jyothikiran25/air-mouse-pcb/docs/board-top.png

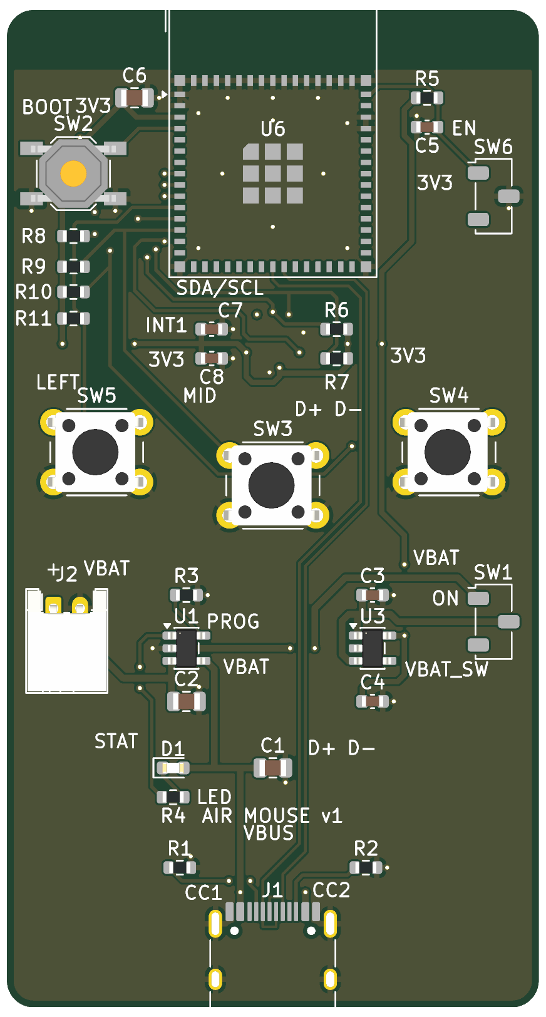
docs/board-top.png
