jyothikiran25/air-mouse-pcb/docs/route-map.png

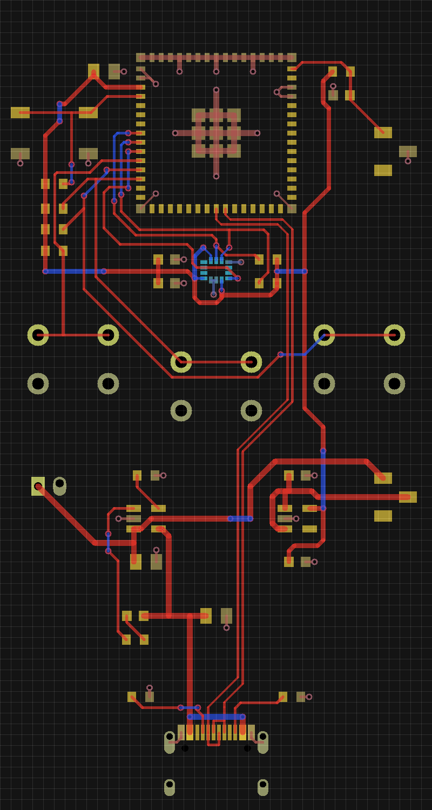
docs/route-map.png
