jyothikiran25/air-mouse-pcb/AIR_MOUSE.kicad_pcb

## KiCad design AIR_MOUSE.kicad_pcb (2026-11-07)

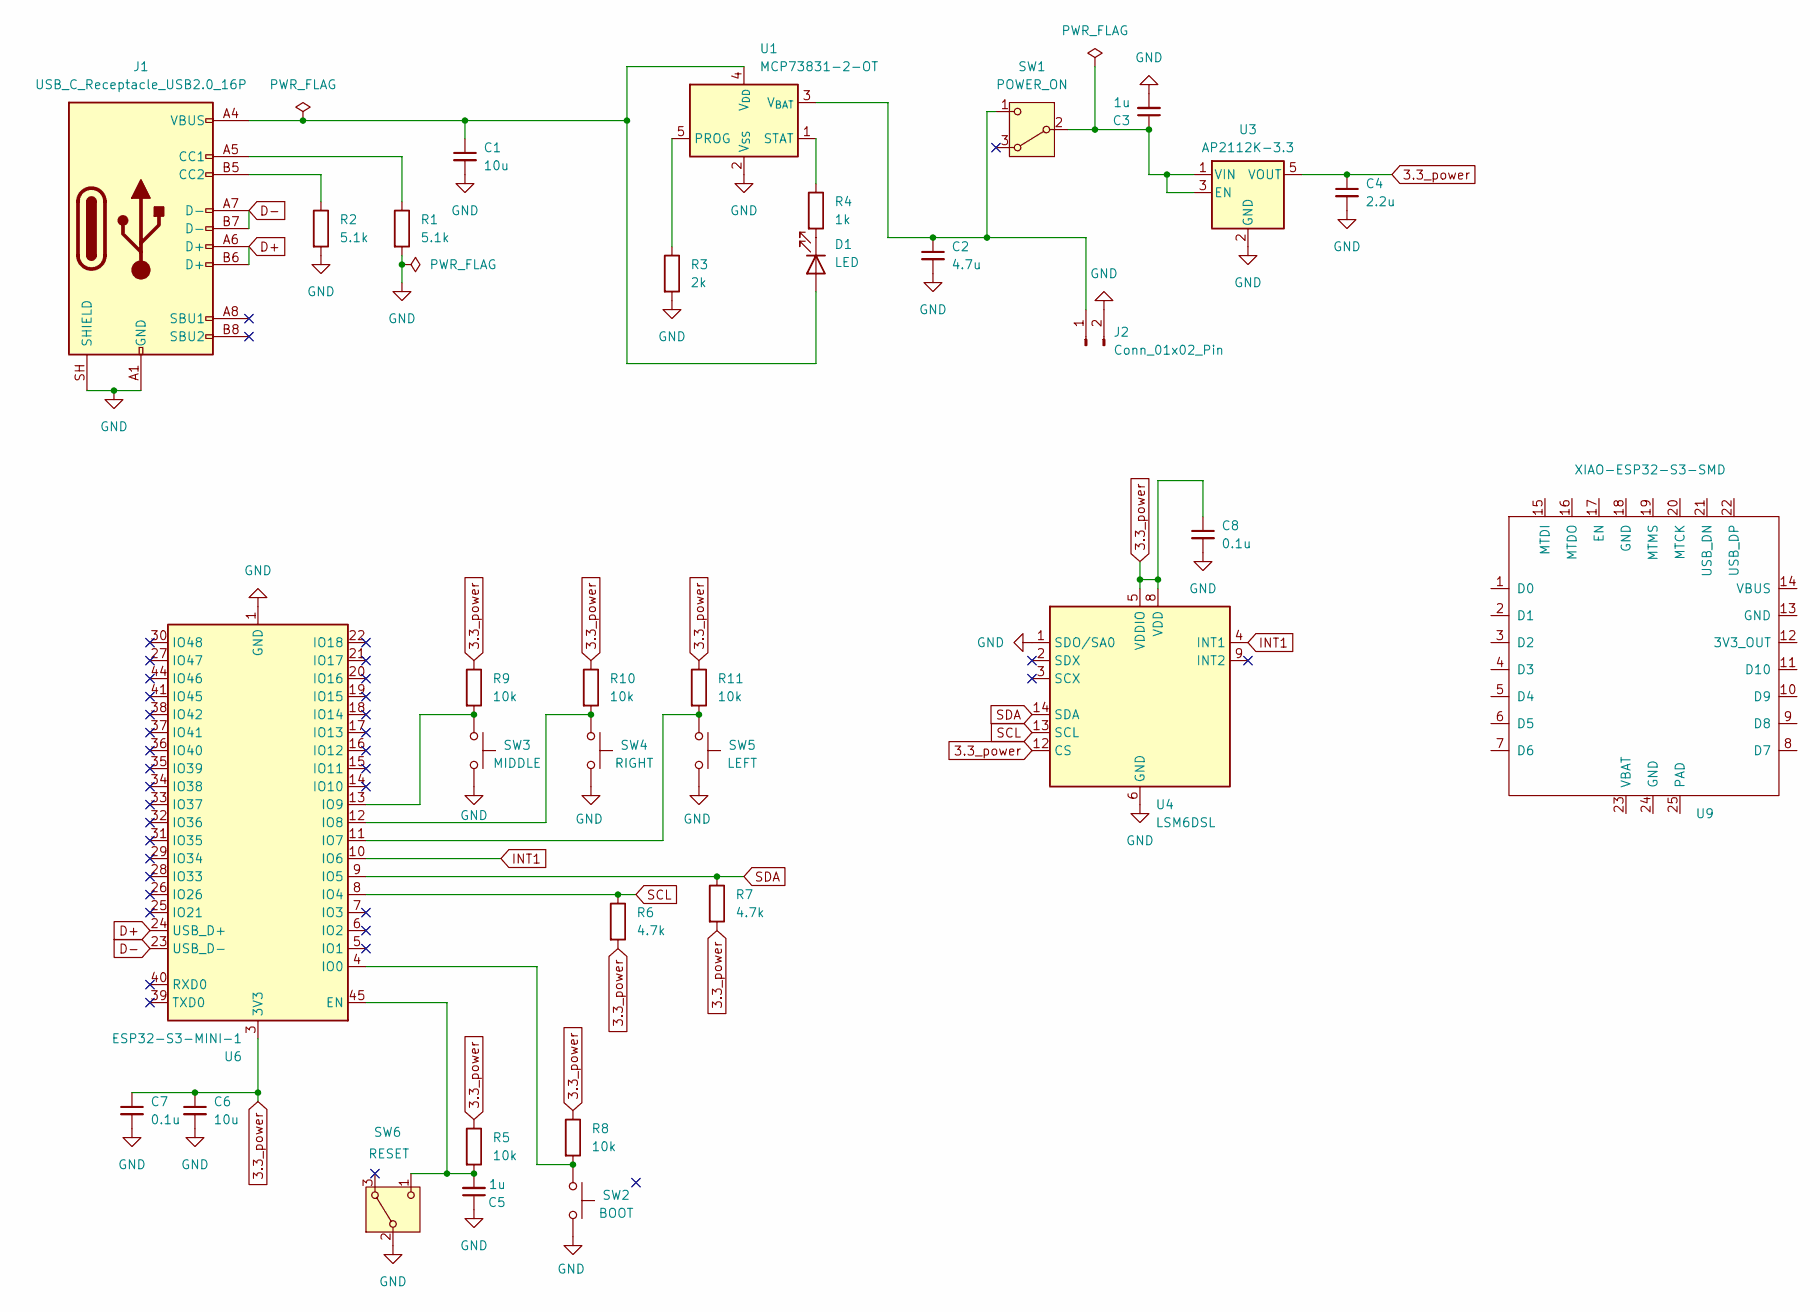
[picture p3: schematic AIR_MOUSE.kicad_sch]

Parts:
C1, C6: 10u; C_0805_2012Metric
C2: 4.7u; C_0805_2012Metric
C3, C5: 1u; C_0603_1608Metric
C4: 2.2u; C_0603_1608Metric
C7, C8: 0.1u; C_0603_1608Metric
D1: LED; LED_0603_1608Metric
J1: USB_C_Receptacle_USB2.0_16P; USB_C_Receptacle_HRO_TYPE-C-31-M-12
J2: Conn_01x02_Pin; JST_PH_S2B-PH-K_1x02_P2.00mm_Horizontal
R1, R2: 5.1k; R_0603_1608Metric
R3: 2k; R_0603_1608Metric
R4: 1k; R_0603_1608Metric
R5, R8, R9, R10, R11: 10k; R_0603_1608Metric
R6, R7: 4.7k; R_0603_1608Metric
SW1: POWER_ON; Nidec_Copal_CAS-120A
SW2: BOOT; SW_SPST_TL3342
SW3: MIDDLE; SW_PUSH_6mm_H5mm
SW4: RIGHT; SW_PUSH_6mm_H5mm
SW5: LEFT; SW_PUSH_6mm_H5mm
SW6: RESET; Nidec_Copal_CAS-120A
U1: MCP73831-2-OT; SOT-23-5
U3: AP2112K-3.3; SOT-23-5
U4: LSM6DSL; LGA-14_3x2.5mm_P0.5mm_LayoutBorder3x4y
U6: ESP32-S3-MINI-1; ESP32-S2-MINI-1
U9: XIAO-ESP32-S3-SMD

Connections:
3.3_power: C4.1, C6.1, C7.1, C8.1, R5.1, R6.2, R7.2, R8.1, R9.1, R10.1, R11.1, U3.5 (VOUT), U4.5 (VDDIO), U4.8 (VDD), U4.12 (CS), U6.3 (3V3)
D+: J1.A6 (D+), J1.B6 (D+), U6.24 (USB_D+)
D-: J1.A7 (D-), J1.B7 (D-), U6.23 (USB_D-)
GND: C1.2, C2.2, C3.2, C4.2, C5.1, C6.2, C7.2, C8.2, J1.A1 (GND), J1.A12 (GND), J1.B1 (GND), J1.B12 (GND), J1.SH (SHIELD), J2.2, R1.2, R2.2, R3.2, SW2.2, SW3.2, SW4.2, SW5.2, SW6.2 (B), U1.2 (V_{SS}), U3.2 (GND), U4.1 (SDO/SA0), U4.6 (GND), U4.7 (GND), U6.1 (GND), U6.2 (GND), U6.42 (GND), U6.43 (GND), U6.46 (GND), U6.47 (GND), U6.48 (GND), U6.49 (GND), U6.50 (GND), U6.51 (GND), U6.52 (GND), U6.53 (GND), U6.54 (GND), U6.55 (GND), U6.56 (GND), U6.57 (GND), U6.58 (GND), U6.59 (GND), U6.60 (GND), U6.61 (GND), U6.62 (GND), U6.63 (GND), U6.64 (GND), U6.65 (GND)
INT1: U4.4 (INT1), U6.10 (IO6)
unnamed: C1.1, D1.2 (A), J1.A4 (VBUS), J1.A9 (VBUS), J1.B4 (VBUS), J1.B9 (VBUS), U1.4 (V_{DD})
unnamed: D1.1 (K), R4.2
unnamed: J1.A5 (CC1), R1.1
unnamed: J1.B5 (CC2), R2.1
unnamed: C2.1, J2.1, SW1.1 (C), U1.3 (V_{BAT})
unnamed: C3.1, SW1.2 (B), U3.1 (VIN), U3.3 (EN)
unnamed: C5.2, R5.2, SW6.1 (C), U6.45 (EN)
unnamed: R3.1, U1.5 (PROG)
unnamed: R4.1, U1.1 (STAT)
unnamed: R8.2, SW2.1, U6.4 (IO0)
unnamed: R11.2, SW5.1, U6.11 (IO7)
unnamed: R10.2, SW4.1, U6.12 (IO8)
unnamed: R9.2, SW3.1, U6.13 (IO9)
SCL: R6.1, U4.13 (SCL), U6.8 (IO4)
SDA: R7.1, U4.14 (SDA), U6.9 (IO5)

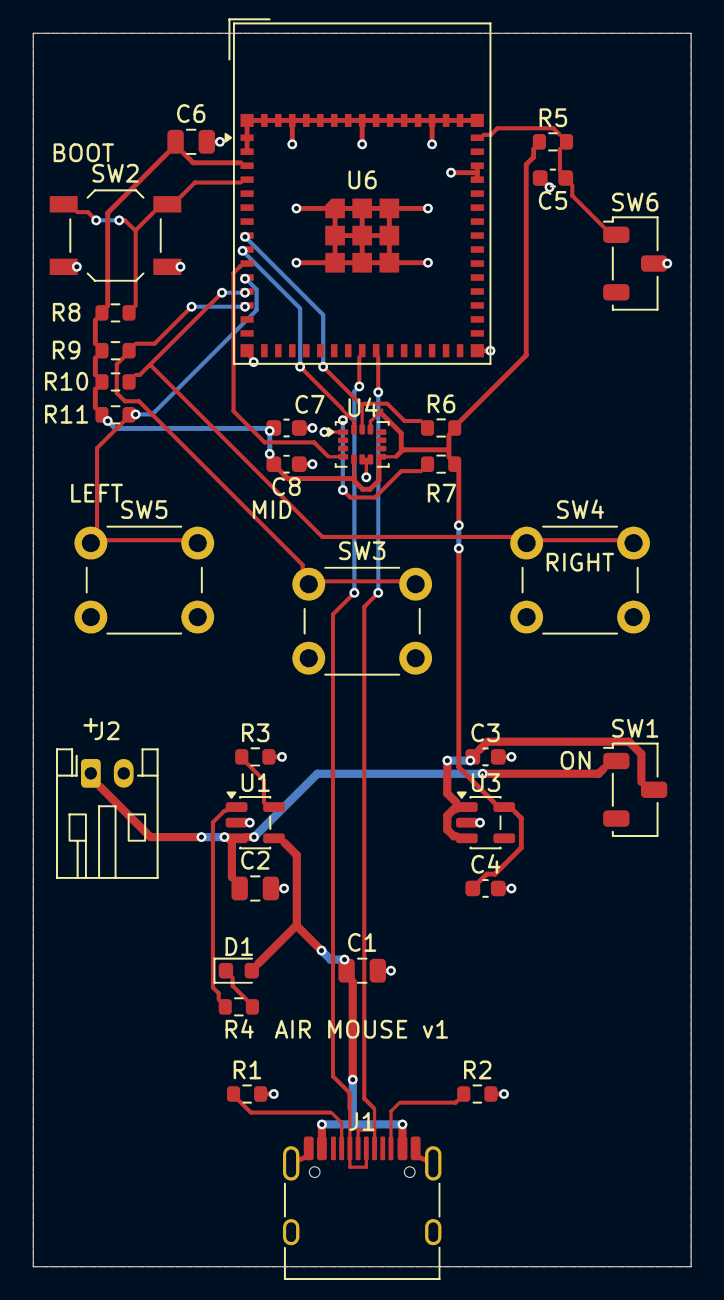
[picture p4: board AIR_MOUSE.kicad_pcb from above]

Board: 2 copper layers, 40.0 x 75.0 mm, 32 parts (0 on the bottom side), 20 nets.
