jyothikiran25/air-mouse-pcb/(commit log)

2026-10-31 Initial project: schematic + unrouted PCB
    [AIR_MOUSE.kicad_pcb, AIR_MOUSE.kicad_sch]
2026-11-03 Placement done
    [AIR_MOUSE.kicad_pcb]
2026-11-04 routing: cleared
    Delete all hand-drawn tracks/vias; include Board Setup (net classes, U4 fine-pitch DRC rule).
    [AIR_MOUSE.kicad_pcb]
2026-11-04 routing: usb + imu escapes
    USB-C D+/D-/CC/VBUS/GND escapes per spec; LSM6DSL escapes mirrored in X because U4 sits on B.Cu at 180 deg.
    [AIR_MOUSE.kicad_pcb]
2026-11-04 routing: all signals
    D+/D- hand-placed pair (right of C1, SW3/SW4 corridor, under U6 bottom row); remaining nets grid-A* routed on F.Cu with short B.Cu hops for crossings.
    [AIR_MOUSE.kicad_pcb]
2026-11-04 ground zones
    GND stub+via on every GND SMD pad, ESP32 thermal block joined with 4 vias, top-row GND bus with 3 vias, F.Cu/B.Cu GND pours (0.3 clr, 0.25 min, thermals). VBAT/STAT rerouted to free U1 pin 2; J1 GND SMD pads use solid zone connection.
    [AIR_MOUSE.kicad_pcb]
2026-11-04 drc clean
    kicad-cli DRC (refill, all severities, parity): 0 errors, 0 unconnected; only expected U9 parity issue plus warnings (silkscreen, U4 lib mismatch, one stitched 3V3 via flagged dangling).
2026-11-04 silkscreen
    Move crowded reference texts off pads/other silk (0.8 mm refs for small passives), add 'AIR MOUSE v1', '+' at J2 pin 1 and 'ON' at SW1.
    [AIR_MOUSE.kicad_pcb]
2026-11-04 fab outputs v1
    Gerbers (F/B Cu, Mask, Silkscreen, Paste, Edge.Cuts), Excellon PTH/NPTH drills + maps, zipped as gerbers.zip.
    [AIR_MOUSE-B_Cu.gbl, AIR_MOUSE-B_Mask.gbs, AIR_MOUSE-B_Paste.gbp, AIR_MOUSE-B_Silkscreen.gbo, AIR_MOUSE-Edge_Cuts.gm1, AIR_MOUSE-F_Cu.gtl, AIR_MOUSE-F_Mask.gts, AIR_MOUSE-F_Paste.gtp]
2026-11-07 fab rules: JLCPCB minimums
    Hole clearance 0.3, min via 0.6, silkscreen text min 1.0/0.15. Also carries KiCad's own project-file rewrite (same_local_global_power, used_designators order).
2026-11-07 routing: tidy signal and power routes
    Rewrite router output as explicit straight runs ending on pad centres. 3V3 now has one trunk (x=128.2) instead of the right-edge detour; VBAT/VBAT_SW no longer wrap U3; single hops for IO8 and the 3V3 link. J1/U4 escapes, D+/D- and footprints unchanged.
    [AIR_MOUSE.kicad_pcb]
2026-11-07 silkscreen: label routes, meet 1.0/0.15 text minimum
    Add net-name labels along the main routes (VBUS, VBAT, VBAT_SW, 3V3, D+ D-, CC1/2, SDA/SCL, INT1, LEFT/MID/RIGHT, BOOT, EN, PROG, STAT, LED) and bring all references up to 1.0 mm / 0.15 mm.
    [AIR_MOUSE.kicad_pcb]
2026-11-07 fab outputs v2
    Regenerate Gerbers, Excellon drills, drill maps and gerbers.zip from the tidied, labelled board.
    [AIR_MOUSE-B_Cu.gbl, AIR_MOUSE-B_Mask.gbs, AIR_MOUSE-B_Paste.gbp, AIR_MOUSE-B_Silkscreen.gbo, AIR_MOUSE-Edge_Cuts.gm1, AIR_MOUSE-F_Cu.gtl, AIR_MOUSE-F_Mask.gts, AIR_MOUSE-F_Paste.gtp]
2026-11-07 outline: 2 mm corner radius
    Set the Edge.Cuts rectangle to the specified 2 mm corners and refill the GND pours. Tracks, vias, footprints and silkscreen unchanged.
    [AIR_MOUSE.kicad_pcb]
2026-11-07 fab outputs v3
    Regenerate Gerbers, drills, maps and gerbers.zip with the 2 mm rounded outline.
    [AIR_MOUSE-B_Cu.gbl, AIR_MOUSE-B_Mask.gbs, AIR_MOUSE-B_Paste.gbp, AIR_MOUSE-B_Silkscreen.gbo, AIR_MOUSE-Edge_Cuts.gm1, AIR_MOUSE-F_Cu.gtl, AIR_MOUSE-F_Mask.gts, AIR_MOUSE-F_Paste.gtp]
2026-11-07 PCB cleanup: IMU back on top side, clean 45/90-degree routing
    - U4 (LSM6DSL) was flipped to the bottom side; restored to top as originally placed
    (single-sided assembly, unbroken bottom ground plane, original sensor axes)
    - Rerouted all nets with only horizontal, vertical and 45-degree segments
    - Kept placement, outline, rules, net classes and JLCPCB rule updates
    - Removed per-track silkscreen labels that no longer matched the routes
    - Cleared stale zone fills: press B in KiCad to refill
    - Gerbers in gerbers/ are from the previous layout and must be regenerated
    Claude-Session: https://claude.ai/code/session_01AB9N5nXdsEEWCVFrbttL4g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
    [AIR_MOUSE.kicad_pcb]
2026-11-07 Design rules: copper-to-hole clearance 0.28 mm, silkscreen text height 1.0 mm
    Claude-Session: https://claude.ai/code/session_01AB9N5nXdsEEWCVFrbttL4g
